kvitekp/midi2trigger/pcb/midi2trigger.sch

## EAGLE design pcb/midi2trigger.sch (2020-02-08)

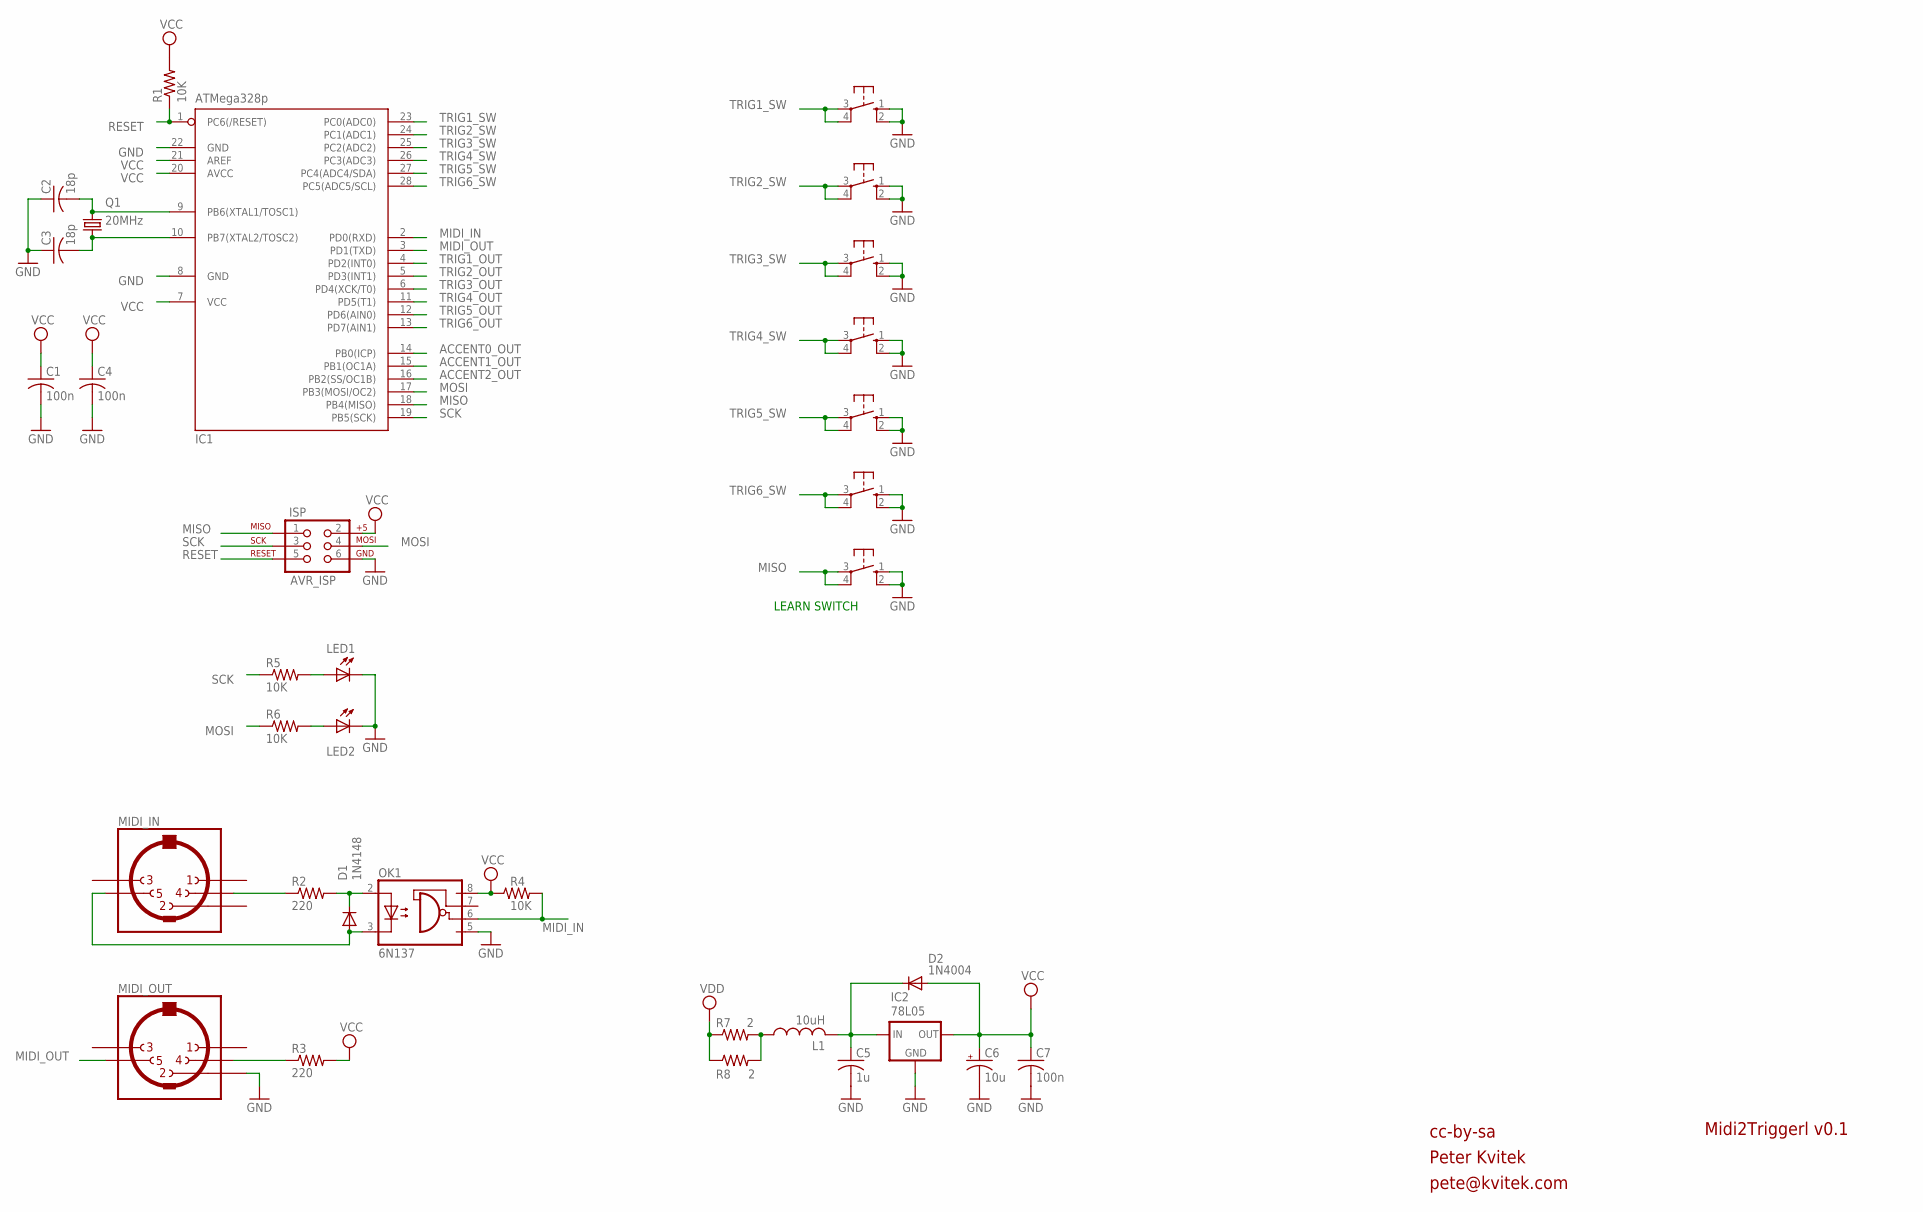
[picture p1: schematic midi2trigger.sch]

Parts:
C1, C4, C7: 100n; C025-025X050
C2, C3: 18p; C025-025X050
C5: 1u; C025-025X050
C6: 10u; E2,5-5
D1: 1N4148; D-5
D2: 1N4004; DO41-10
IC1: ATMega328p; DIL28-3
IC2: 78L05; 78LXX
ISP: AVR_ISP; 2X3
L1: 10uH; 0207/10
LED1, LED2: LED3MM
MIDI_IN: MAB5SH
MIDI_OUT: MAB5SH
OK1: 6N137; DIL08
Q1: 20MHz; HC49U-V
R1, R4, R5, R6: 10K; 0204/7
R2, R3: 220; 0204/7
R7, R8: 2; 0204/7
SW1, SW2, SW3, SW4, SW5, SW6, SW7: 40-XX; B3F-40XX

Connections:
ACCENT0_OUT: IC1.14 (PB0(ICP))
ACCENT1_OUT: IC1.15 (PB1(OC1A))
ACCENT2_OUT: IC1.16 (PB2(SS/OC1B))
GND: C1.2, C2.1, C3.1, C4.2, C5.2, C6.-, C7.2, IC1.8 (GND), IC1.22 (GND), IC2.GND, ISP.6, LED1.K (C), LED2.K (C), MIDI_OUT.2, OK1.5 (GND), SW1.1 (S), SW1.2 (S1), SW2.1 (S), SW2.2 (S1), SW3.1 (S), SW3.2 (S1), SW4.1 (S), SW4.2 (S1), SW5.1 (S), SW5.2 (S1), SW6.1 (S), SW6.2 (S1), SW7.1 (S), SW7.2 (S1)
MIDI_IN: IC1.2 (PD0(RXD)), OK1.6 (VO), R4.2
MIDI_OUT: IC1.3 (PD1(TXD)), MIDI_OUT.5
MISO: IC1.18 (PB4(MISO)), ISP.1, SW7.3, SW7.4 (P1)
MOSI: IC1.17 (PB3(MOSI/OC2)), ISP.4, R6.1
unnamed: L1.1, R7.2, R8.2
unnamed: D1.C, OK1.2 (A), R2.2
unnamed: MIDI_OUT.4, R3.1
unnamed: LED1.A, R5.2
unnamed: LED2.A, R6.2
unnamed: MIDI_IN.4, R2.1
unnamed: D1.A, MIDI_IN.5, OK1.3 (C)
unnamed: C3.2, IC1.10 (PB7(XTAL2/TOSC2)), Q1.1
unnamed: C2.2, IC1.9 (PB6(XTAL1/TOSC1)), Q1.2
RESET: IC1.1 (PC6(/RESET)), ISP.5, R1.1
SCK: IC1.19 (PB5(SCK)), ISP.3, R5.1
TRIG1_OUT: IC1.4 (PD2(INT0))
TRIG1_SW: IC1.23 (PC0(ADC0)), SW1.3, SW1.4 (P1)
TRIG2_OUT: IC1.5 (PD3(INT1))
TRIG2_SW: IC1.24 (PC1(ADC1)), SW2.3, SW2.4 (P1)
TRIG3_OUT: IC1.6 (PD4(XCK/T0))
TRIG3_SW: IC1.25 (PC2(ADC2)), SW3.3, SW3.4 (P1)
TRIG4_OUT: IC1.11 (PD5(T1))
TRIG4_SW: IC1.26 (PC3(ADC3)), SW4.3, SW4.4 (P1)
TRIG5_OUT: IC1.12 (PD6(AIN0))
TRIG5_SW: IC1.27 (PC4(ADC4/SDA)), SW5.3, SW5.4 (P1)
TRIG6_OUT: IC1.13 (PD7(AIN1))
TRIG6_SW: IC1.28 (PC5(ADC5/SCL)), SW6.3, SW6.4 (P1)
VCC: C1.1, C4.1, C6.+, C7.1, D2.A, IC1.7 (VCC), IC1.20 (AVCC), IC1.21 (AREF), IC2.OUT, ISP.2, OK1.8 (VCC), R1.2, R3.2, R4.1
VDD: R7.1, R8.1
VREG_IN: C5.1, D2.C, IC2.IN, L1.2

Notes on the sheet:
cc-by-sa
Peter Kvitek
pete@kvitek.com
Midi2Triggerl v0.1
LEARN SWITCH
