kvitekp/midi2trigger/src/midi2trigger/hardware_config.h

// Copyright 2015 Peter Kvitek.
//
// Author: Peter Kvitek (pete@kvitek.com)
//
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
// -----------------------------------------------------------------------------
//
// Hardware configuration.

#ifndef MIDI2TRIGGER_HARDWARE_CONFIG_H_
#define MIDI2TRIGGER_HARDWARE_CONFIG_H_

#include "avrlib/base.h"
#include "avrlib/gpio.h"
#include "avrlib/serial.h"
#include "avrlib/parallel_io.h"
#include "avrlib/devices/switch.h"
#include "avrlib/devices/switch_array.h"

namespace midi2trigger {

using avrlib::Gpio;
using avrlib::LSB_FIRST;
using avrlib::MSB_FIRST;
using avrlib::PARALLEL_TRIPLE_LOW;
using avrlib::PARALLEL_HEXTUPLE_LOW;
using avrlib::PARALLEL_HEXTUPLE_HIGH;
using avrlib::DebouncedSwitch;
using avrlib::ParallelPort;
using avrlib::SwitchArray;
using avrlib::PortB;
using avrlib::PortC;
using avrlib::PortD;
using avrlib::SerialPort0;

// MIDI
typedef SerialPort0 MidiPort;

// Switches
typedef Gpio<PortB, 4> LearnSwitchPort;
typedef DebouncedSwitch< LearnSwitchPort > LearnSwitch;
typedef SwitchArray<6, PortC, PARALLEL_HEXTUPLE_LOW> TriggerSwitches;

// Triggers
typedef ParallelPort<PortD, PARALLEL_HEXTUPLE_HIGH> TriggerPorts;

// Accents
typedef ParallelPort<PortB, PARALLEL_TRIPLE_LOW> AccentPorts;

// LEDs
typedef Gpio<PortB, 5> Led1Port;
typedef Gpio<PortB, 3> Led2Port;

// IO
typedef Gpio<PortB, 0> IOPort;  // Reused Accent1

}  // namespace midi2trigger

#endif  // MIDI2TRIGGER_HARDWARE_CONFIG_H_
